median-dispersion/SBM-20-Geiger-Counter/Hardware/Geiger Tube Driver/PCB Back - Geiger Tube Driver.png

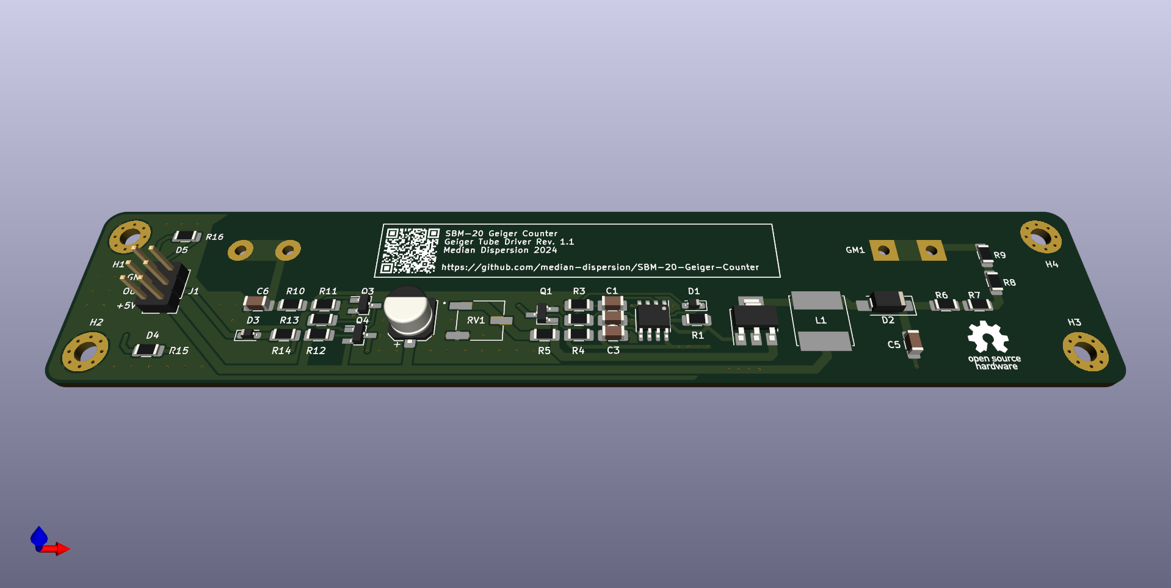
Hardware/Geiger Tube Driver/PCB Back - Geiger Tube Driver.png
