median-dispersion/SBM-20-Geiger-Counter/README.md

# SBM-20 Geiger Counter

### ⚠️  DISCLAIMER
This is a hobbyist project and should not be used to accurately determine radiation levels, especially not if those radiation levels are potentially dangerous and or lethal!
