median-dispersion/SBM-20-Geiger-Counter/Hardware/Geiger Counter Mainboard/Gerber/info.txt

--- Gerber Files ---
Date: 2024-01-08
KiCad: 7.0
PCB manufacturer: PCBWay (2-layer standard)
