median-dispersion/SBM-20-Geiger-Counter/Hardware/Geiger Tube Driver/Gerber/info.txt

--- Gerber Files ---
Date: 2024-01-07
KiCad: 7.0
PCB manufacturer: PCBWay (2-layer standard)
