median-dispersion/SBM-20-Geiger-Counter/Hardware/Geiger Counter Mainboard/PCB Back - Geiger Counter Mainboard.png

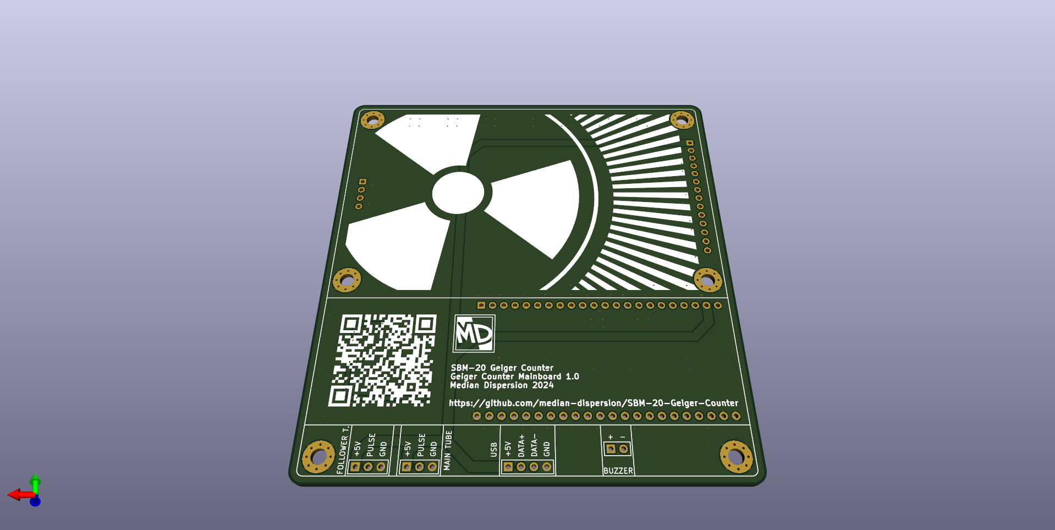
Hardware/Geiger Counter Mainboard/PCB Back - Geiger Counter Mainboard.png
