median-dispersion/SBM-20-Geiger-Counter/Hardware/Geiger Tube Driver/PCB Front - Geiger Tube Driver.png

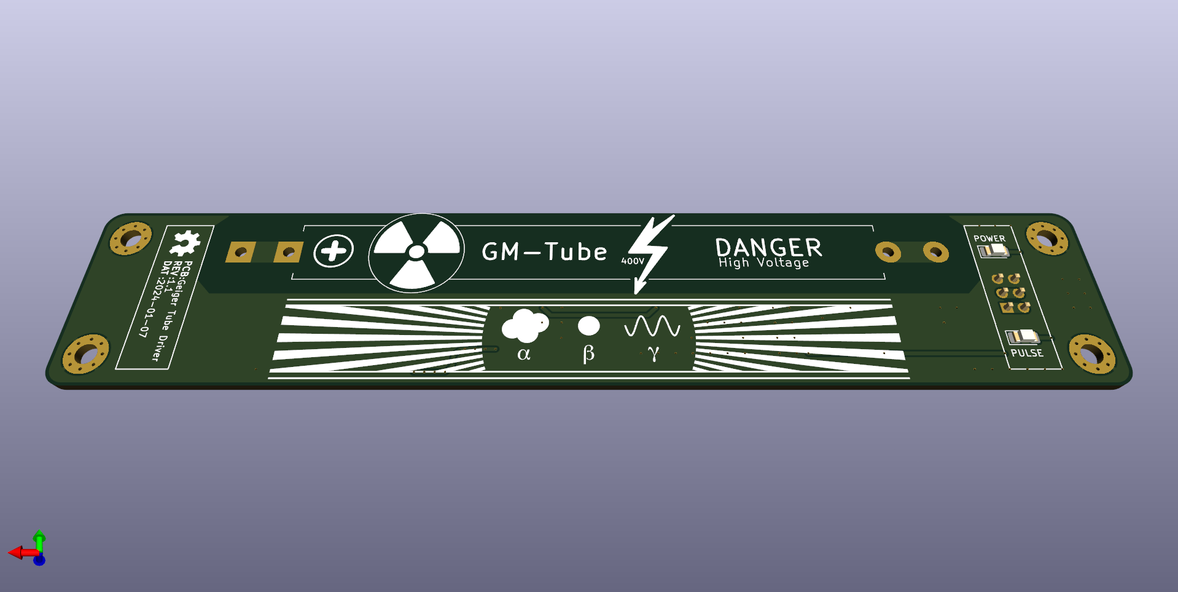
Hardware/Geiger Tube Driver/PCB Front - Geiger Tube Driver.png
