median-dispersion/SBM-20-Geiger-Counter/Hardware/Geiger Counter Mainboard/Schematic - Geiger Counter Mainboard.pdf

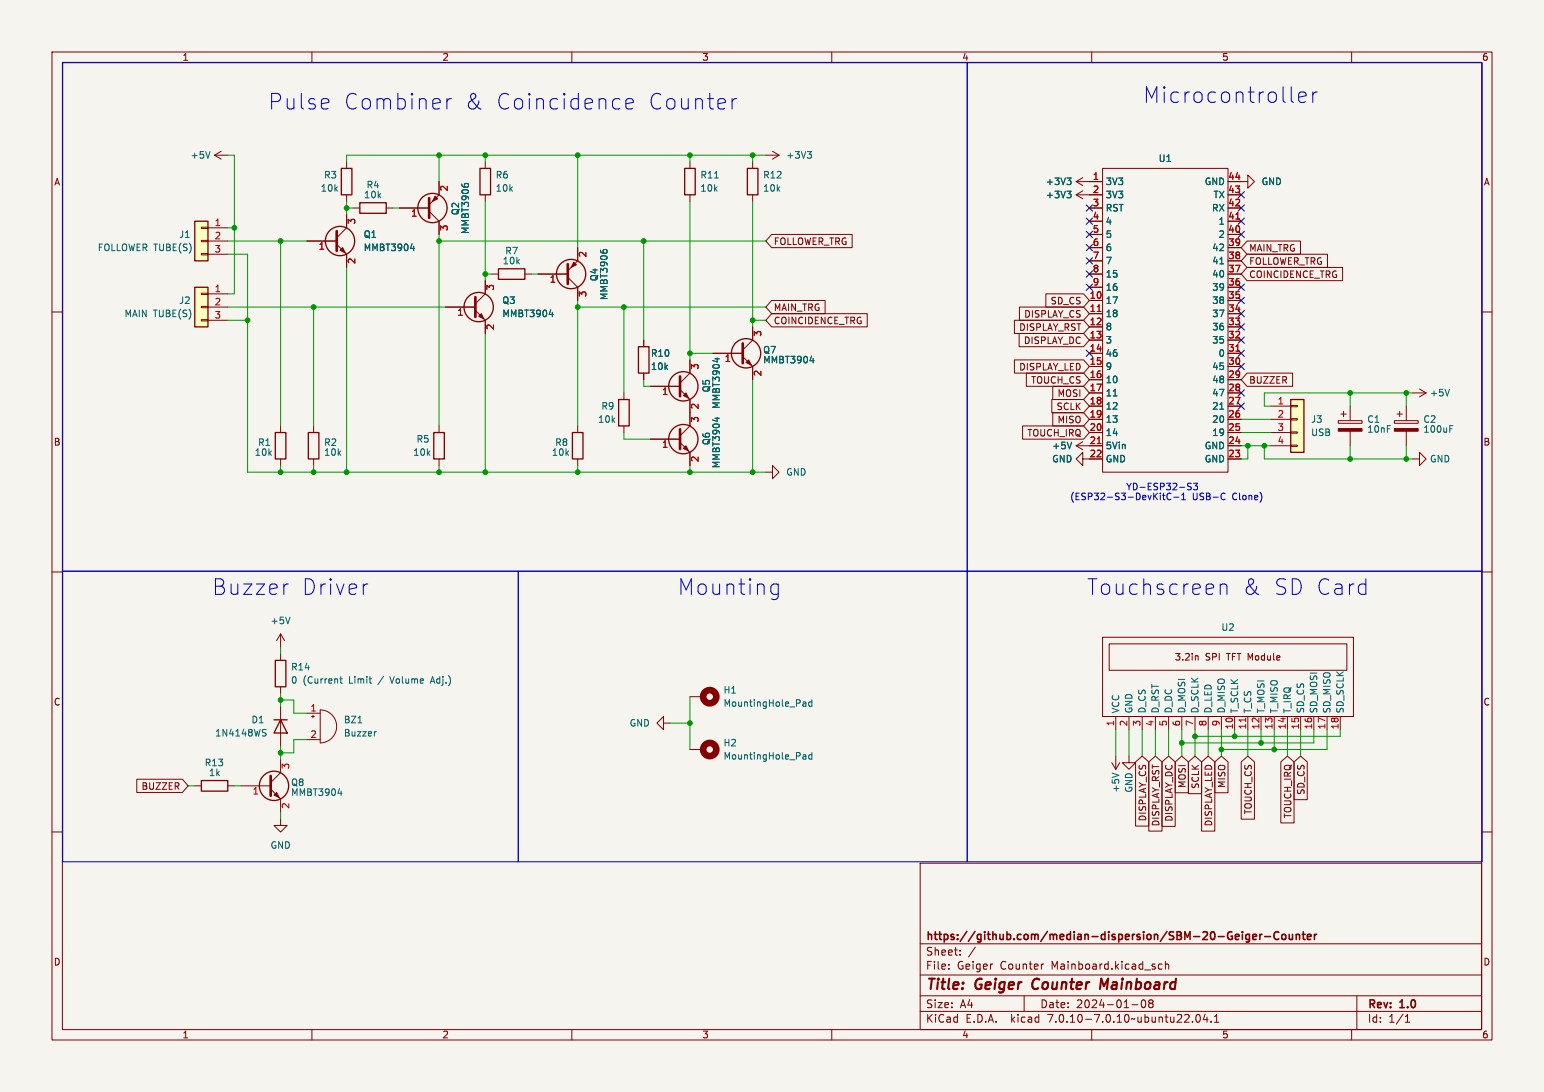
[picture p5: page 1]

Id: 1/1 Title: Geiger Counter Mainboard
