median-dispersion/SBM-20-Geiger-Counter/Hardware/Geiger Tube Driver/Schematic - Geiger Tube Driver.pdf

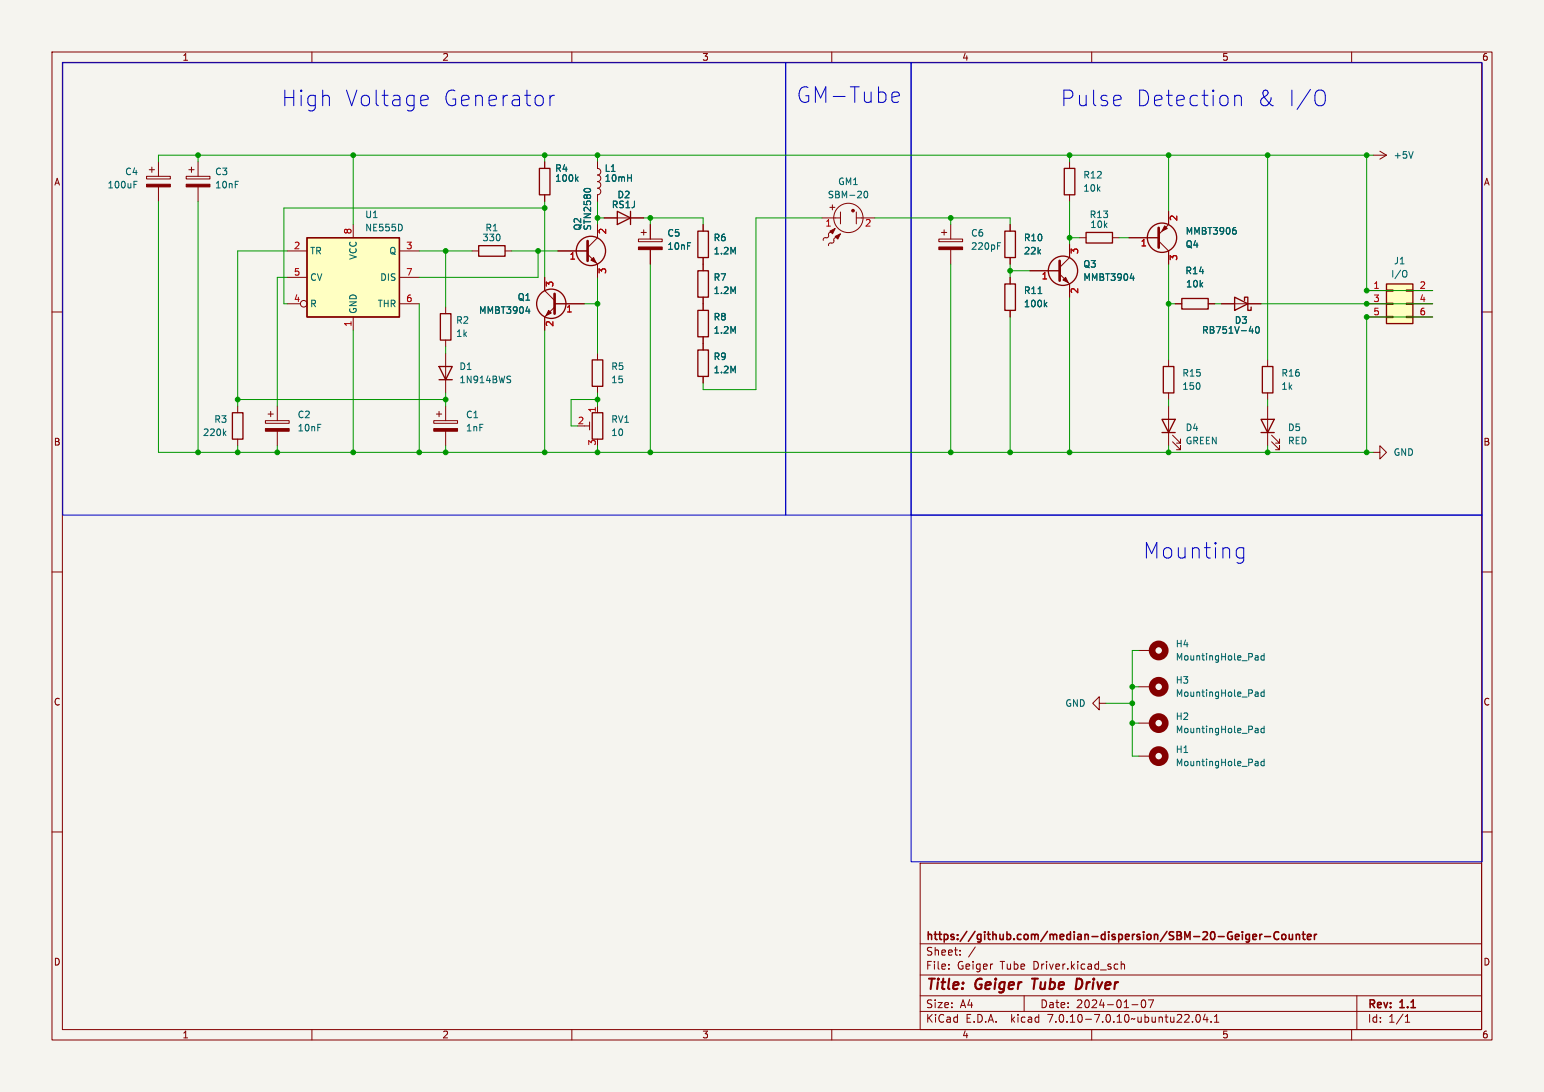
[picture p6: page 1]
