median-dispersion/SBM-20-Geiger-Counter/Hardware/Geiger Tube Driver/KiCad/Geiger Tube Driver.kicad_pcb

## KiCad design Hardware/Geiger Tube Driver/KiCad/Geiger Tube Driver.kicad_pcb (2024-01-09)

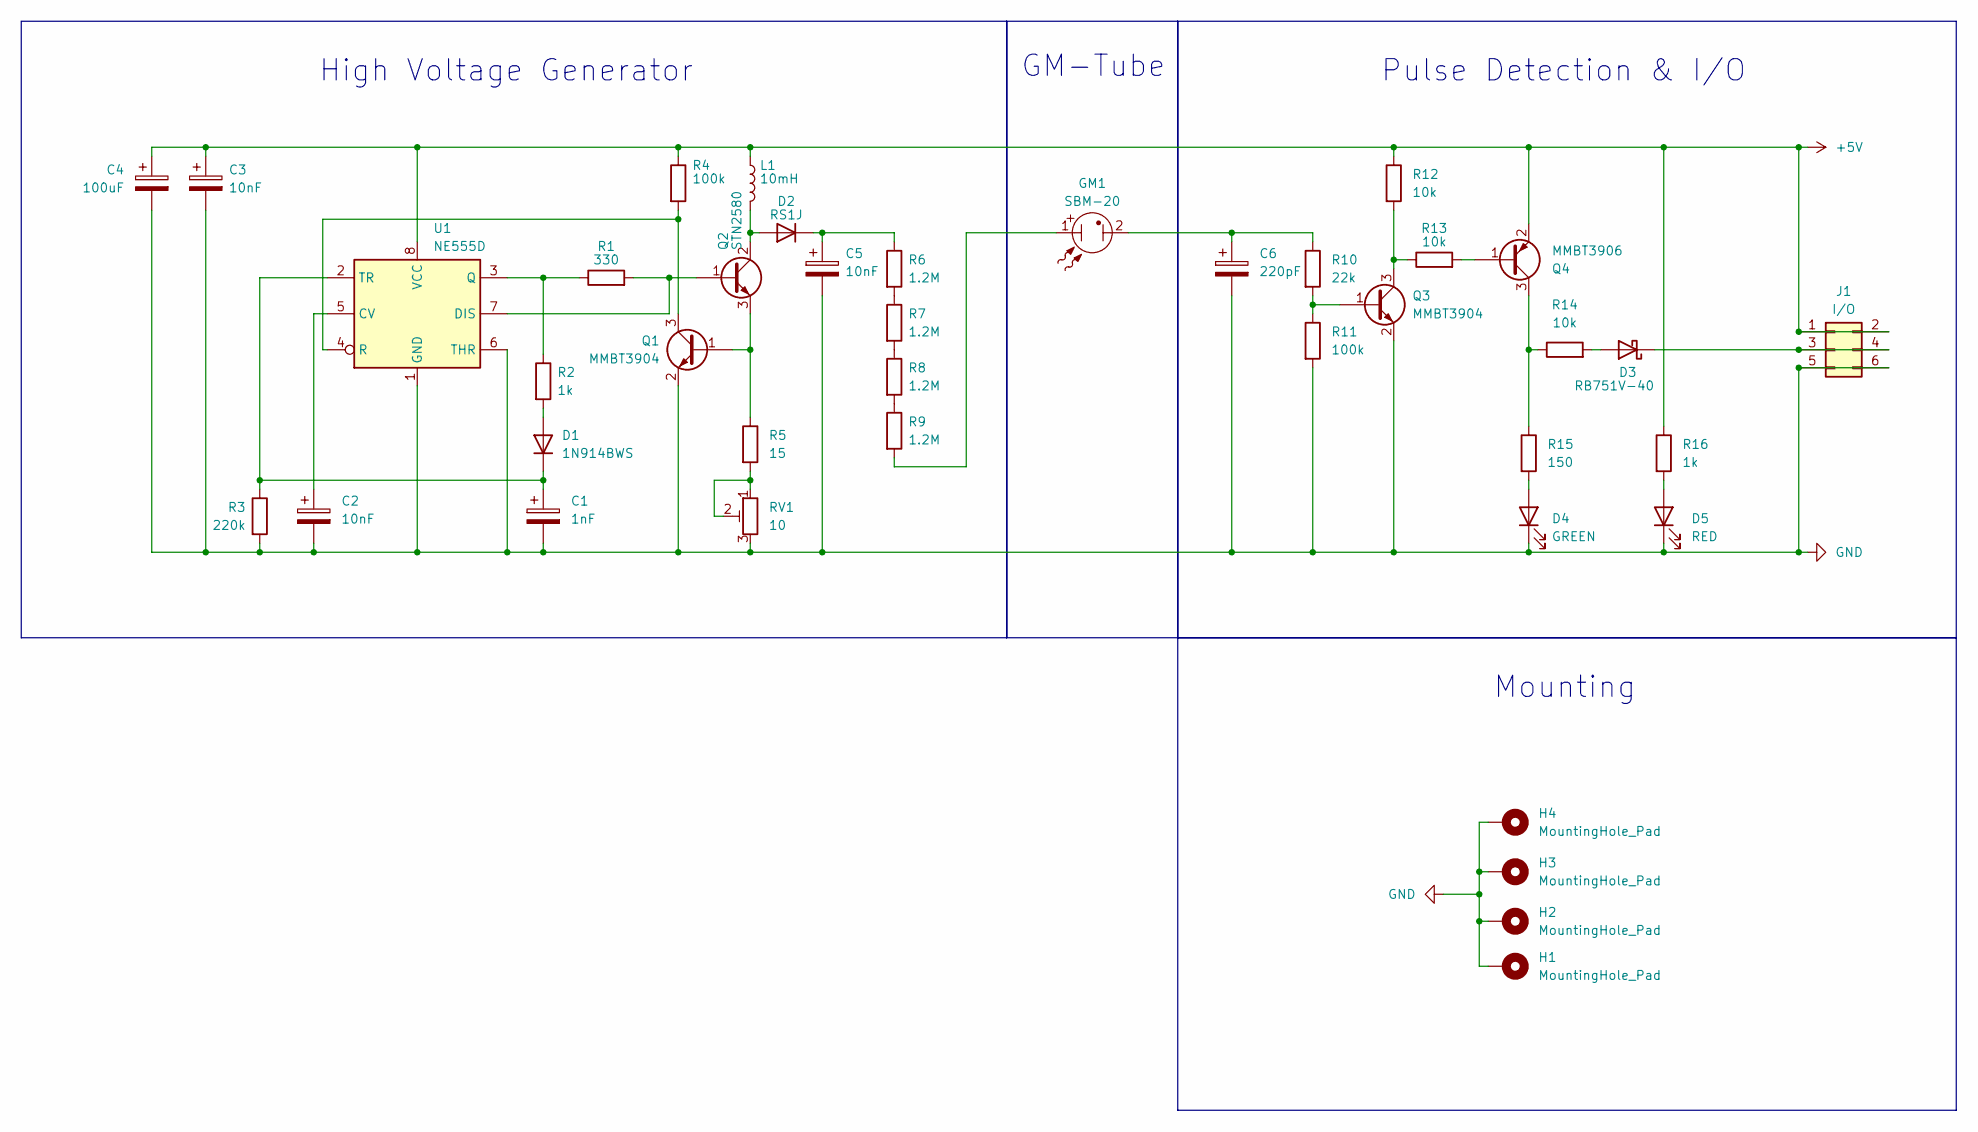
[picture p7: schematic Geiger Tube Driver.kicad_sch]

Parts:
C1: 1nF; C_1206_3216Metric_Pad1.33x1.80mm_HandSolder
C2, C3, C5: 10nF; C_1206_3216Metric_Pad1.33x1.80mm_HandSolder
C4: 100uF; CP_Elec_6.3x5.4
C6: 220pF; C_1206_3216Metric_Pad1.33x1.80mm_HandSolder
D1: 1N914BWS; D_SOD-323_HandSoldering
D2: RS1J; SMA_HV_Handsoldering
D3: RB751V-40; D_SOD-323_HandSoldering
D4: GREEN; LED_1206_3216Metric_Pad1.42x1.75mm_HandSolder
D5: RED; LED_1206_3216Metric_Pad1.42x1.75mm_HandSolder
GM1: SBM-20
H1, H2, H3, H4: MountingHole_Pad; MountingHole_3.2mm_M3_Pad_Via
J1: I/O; PinHeader_2x03_P2.54mm_Vertical
L1: 10mH; 8065_Handsoldering
Q1, Q3: MMBT3904; SOT-23_Handsoldering
Q2: STN2580; SOT-223-3_TabPin2
Q4: MMBT3906; SOT-23_Handsoldering
R1: 330; R_1206_3216Metric_Pad1.30x1.75mm_HandSolder
R2, R16: 1k; R_1206_3216Metric_Pad1.30x1.75mm_HandSolder
R3: 220k; R_1206_3216Metric_Pad1.30x1.75mm_HandSolder
R4, R11: 100k; R_1206_3216Metric_Pad1.30x1.75mm_HandSolder
R5: 15; R_1206_3216Metric_Pad1.30x1.75mm_HandSolder
R6, R7, R8, R9: 1.2M; R_1206_3216Metric_Pad1.30x1.75mm_HandSolder
R10: 22k; R_1206_3216Metric_Pad1.30x1.75mm_HandSolder
R12, R13, R14: 10k; R_1206_3216Metric_Pad1.30x1.75mm_HandSolder
R15: 150; R_1206_3216Metric_Pad1.30x1.75mm_HandSolder
RV1: 10; 3361P-1-100GLF
U1: NE555D; SOIC-8_3.9x4.9mm_P1.27mm

Connections:
+5V: C3.1, C4.1, J1.1, J1.2, L1.1, Q4.2 (E), R4.1, R12.1, R16.1, U1.8 (VCC)
GND: C1.2, C2.2, C3.2, C4.2, C5.2, C6.2, D4.1 (K), D5.1 (K), H1.1, H2.1, H3.1, H4.1, J1.5, J1.6, Q1.2 (E), Q3.2 (E), R3.2, R11.2, RV1.3, U1.1 (GND), U1.6 (THR)
unnamed: C6.1, GM1.2, R10.1
unnamed: D1.2 (A), R2.2
unnamed: C1.1, D1.1 (K), R3.1, U1.2 (TR)
unnamed: D2.2 (A), L1.2, Q2.2 (C), Q2.4 (C)
unnamed: C5.1, D2.1 (K), R6.1
unnamed: D3.2 (A), R14.2
unnamed: D3.1 (K), J1.3, J1.4
unnamed: D4.2 (A), R15.2
unnamed: D5.2 (A), R16.2
unnamed: GM1.1, R9.2
unnamed: Q1.1 (B), Q2.3 (E), R5.1
unnamed: Q1.3 (C), R4.2, U1.4 (R)
unnamed: Q2.1 (B), R1.2, U1.7 (DIS)
unnamed: Q3.1 (B), R10.2, R11.1
unnamed: Q3.3 (C), R12.2, R13.1
unnamed: Q4.1 (B), R13.2
unnamed: Q4.3 (C), R14.1, R15.1
unnamed: R5.2, RV1.1, RV1.2
unnamed: R6.2, R7.1
unnamed: R7.2, R8.1
unnamed: R8.2, R9.1
unnamed: C2.1, U1.5 (CV)
unnamed: R1.1, R2.1, U1.3 (Q)

Notes on the sheet:
Pulse Detection & I/O
High Voltage Generator
GM-Tube
Mounting

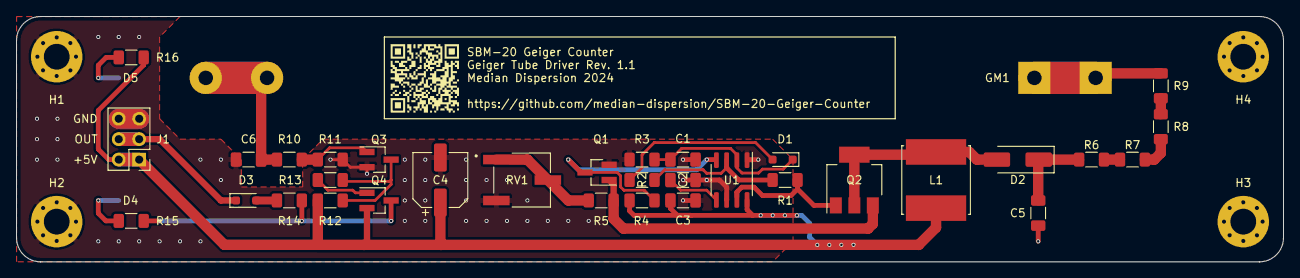
[picture p8: board Geiger Tube Driver.kicad_pcb from above]

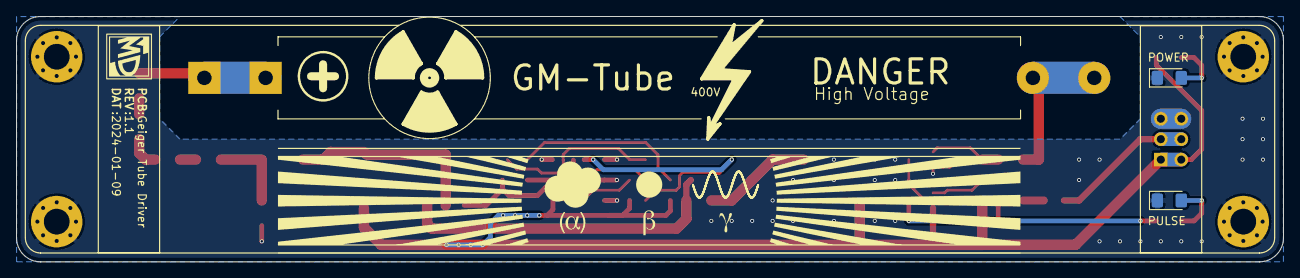
[picture p9: board Geiger Tube Driver.kicad_pcb from below]

Board: 2 copper layers, 157.5 x 30.5 mm, 40 parts (3 on the bottom side), 25 nets.
