median-dispersion/SBM-20-Geiger-Counter/Hardware/Geiger Counter Mainboard/KiCad/Geiger Counter Mainboard.kicad_pcb

## KiCad design Hardware/Geiger Counter Mainboard/KiCad/Geiger Counter Mainboard.kicad_pcb (2024-01-08)

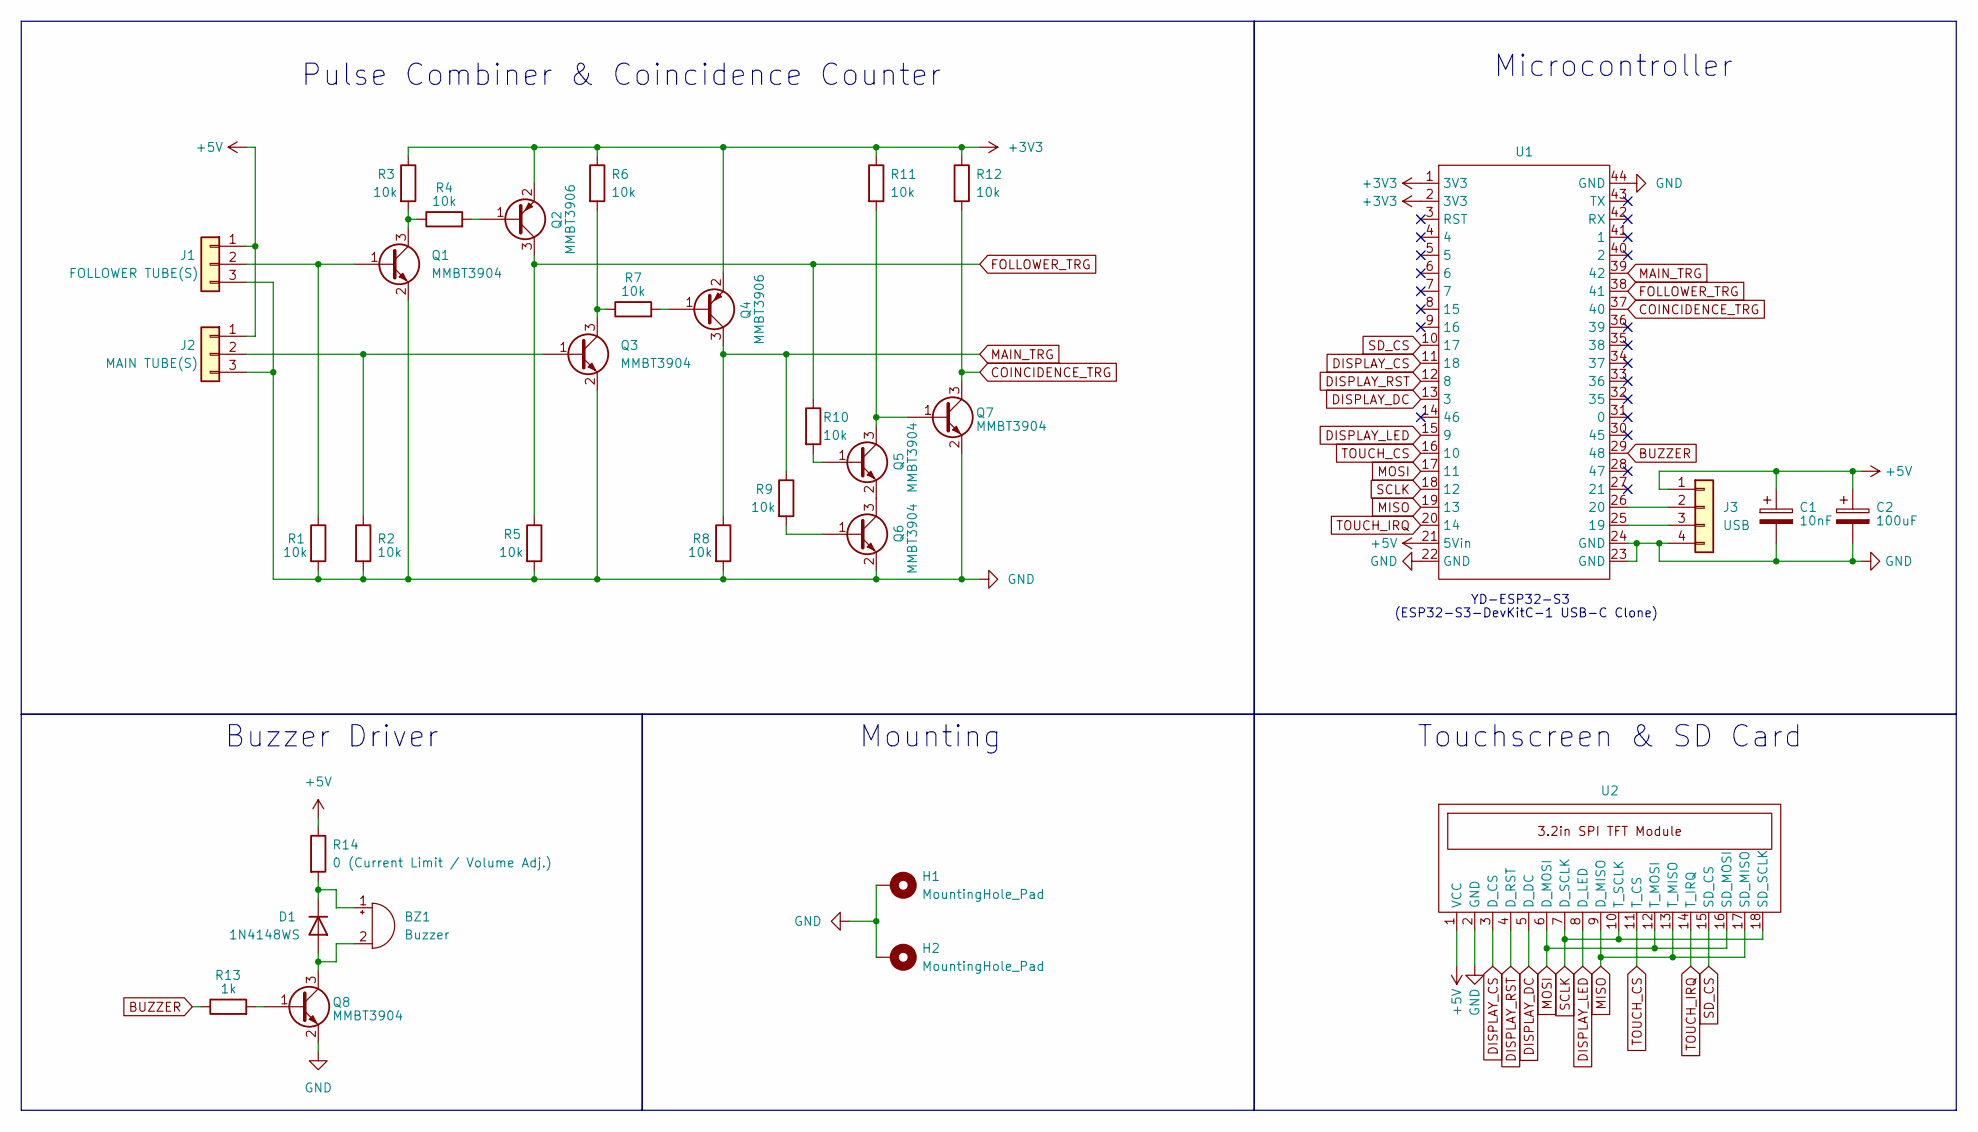
[picture p10: schematic Geiger Counter Mainboard.kicad_sch]

Parts:
BZ1: Buzzer; PinHeader_1x02_P2.54mm_Vertical
C1: 10nF; C_1206_3216Metric_Pad1.33x1.80mm_HandSolder
C2: 100uF; CP_Elec_6.3x5.4
D1: 1N4148WS; D_SOD-323_HandSoldering
H1, H2: MountingHole_Pad; MountingHole_3.2mm_M3_Pad_Via
J1: FOLLOWER TUBE(S); PinHeader_1x03_P2.54mm_Vertical
J2: MAIN TUBE(S); PinHeader_1x03_P2.54mm_Vertical
J3: USB; PinHeader_1x04_P2.54mm_Vertical
Q1, Q3, Q5, Q6, Q7, Q8: MMBT3904; SOT-23_Handsoldering
Q2, Q4: MMBT3906; SOT-23_Handsoldering
R1, R2, R3, R4, R5, R6, R7, R8, R9, R10, R11, R12: 10k; R_1206_3216Metric_Pad1.30x1.75mm_HandSolder
R13: 1k; R_1206_3216Metric_Pad1.30x1.75mm_HandSolder
R14: 0 (Current Limit / Volume Adj.); R_1206_3216Metric_Pad1.30x1.75mm_HandSolder
U1: YD-ESP32-S3 (ESP32-S3-DevKitC-1 USB-C Clone)
U2: 3.2in SPI TFT Touch Module

Connections:
+3V3: Q2.2 (E), Q4.2 (E), R3.1, R6.1, R11.1, R12.1, U1.1 (3V3), U1.2 (3V3)
+5V: C1.1, C2.1, J1.1, J2.1, J3.1, R14.1, U1.21 (5Vin), U2.1 (VCC)
BUZZER: R13.1, U1.29 (48)
COINCIDENCE_TRG: Q7.3 (C), R12.2, U1.37 (40)
DISPLAY_CS: U1.11 (18), U2.3 (D_CS)
DISPLAY_DC: U1.13 (3), U2.5 (D_DC)
DISPLAY_LED: U1.15 (9), U2.8 (D_LED)
DISPLAY_RST: U1.12 (8), U2.4 (D_RST)
FOLLOWER_TRG: Q2.3 (C), R5.1, R10.1, U1.38 (41)
GND: C1.2, C2.2, H1.1, H2.1, J1.3, J2.3, J3.4, Q1.2 (E), Q3.2 (E), Q6.2 (E), Q7.2 (E), Q8.2 (E), R1.2, R2.2, R5.2, R8.2, U1.22 (GND), U1.23 (GND), U1.24 (GND), U1.44 (GND), U2.2 (GND)
MAIN_TRG: Q4.3 (C), R8.1, R9.1, U1.39 (42)
MISO: U1.19 (13), U2.9 (D_MISO), U2.13 (T_MISO), U2.17 (SD_MISO)
MOSI: U1.17 (11), U2.6 (D_MOSI), U2.12 (T_MOSI), U2.16 (SD_MOSI)
unnamed: BZ1.2 (+), D1.2 (A), Q8.3 (C)
unnamed: BZ1.1 (-), D1.1 (K), R14.2
unnamed: J1.2, Q1.1 (B), R1.1
unnamed: J2.2, Q3.1 (B), R2.1
unnamed: J3.2, U1.26 (20)
unnamed: J3.3, U1.25 (19)
unnamed: Q1.3 (C), R3.2, R4.1
unnamed: Q2.1 (B), R4.2
unnamed: Q3.3 (C), R6.2, R7.1
unnamed: Q4.1 (B), R7.2
unnamed: Q5.1 (B), R10.2
unnamed: Q5.3 (C), Q7.1 (B), R11.2
unnamed: Q5.2 (E), Q6.3 (C)
unnamed: Q6.1 (B), R9.2
unnamed: Q8.1 (B), R13.2
SCLK: U1.18 (12), U2.7 (D_SCLK), U2.10 (T_SCLK), U2.18 (SD_SCLK)
SD_CS: U1.10 (17), U2.15 (SD_CS)
TOUCH_CS: U1.16 (10), U2.11 (T_CS)
TOUCH_IRQ: U1.20 (14), U2.14 (T_IRQ)

Notes on the sheet:
Pulse Combiner & Coincidence Counter
(ESP32-S3-DevKitC-1 USB-C Clone)
Buzzer Driver
Microcontroller
Mounting
Touchscreen & SD Card
YD-ESP32-S3

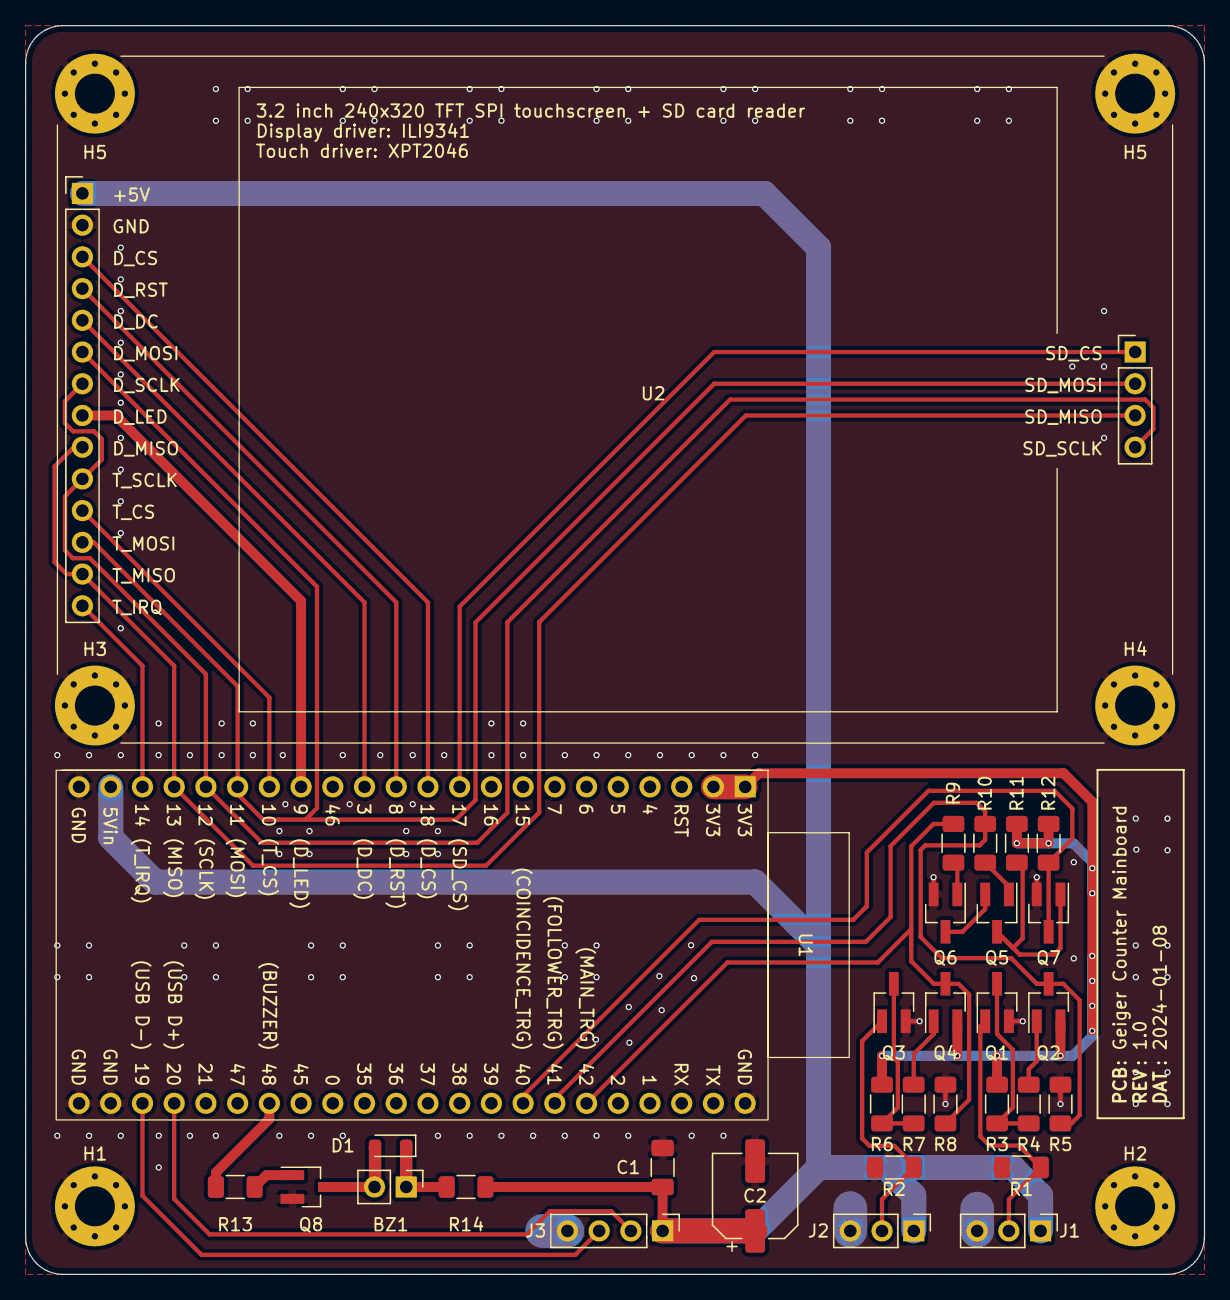
[picture p11: board Geiger Counter Mainboard.kicad_pcb from above]

Board: 2 copper layers, 94.4 x 100.0 mm, 33 parts (0 on the bottom side), 32 nets.
