median-dispersion/SBM-20-Geiger-Counter/(commit log)

2023-09-21 Added files for the Geiger tube driver board.
    [BoM - Geiger Tube Driver.csv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]
2023-12-29 Geiger Tube Driver Rev 1.1
    [BoM - Geiger Tube Driver.csv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]
2023-12-30 Adjusted mounting hole spacing
    [Geiger Tube Driver-B_Cu.gbr, Geiger Tube Driver-B_Mask.gbr, Geiger Tube Driver-B_Paste.gbr, Geiger Tube Driver-B_Silkscreen.gbr, Geiger Tube Driver-Edge_Cuts.gbr, Geiger Tube Driver-F_Cu.gbr, Geiger Tube Driver-F_Mask.gbr, Geiger Tube Driver-F_Paste.gbr]
2023-12-30 Added mainboard schematic
    [Geiger Counter Mainboard.kicad_pcb, Geiger Counter Mainboard.kicad_sch]
2023-12-31 Fixed BoM
    [BoM - Geiger Tube Driver.csv]
2024-01-02 Updated TFT module footprint
    [Geiger Counter Mainboard.kicad_sch]
2024-01-02 Updated TFT module footprint & schematic
    [Geiger Counter Mainboard.kicad_sch]
2024-01-07 Updated schematic & set PCB properties
    [Geiger Counter Mainboard.kicad_pcb, Geiger Counter Mainboard.kicad_sch]
2024-01-07 Added PCB for mainboard
    [Geiger Counter Mainboard.kicad_pcb, Geiger Counter Mainboard.kicad_sch]
2024-01-07 Organized schematics & rounded PCB corners
    [Geiger Tube Driver-B_Cu.gbr, Geiger Tube Driver-B_Mask.gbr, Geiger Tube Driver-B_Paste.gbr, Geiger Tube Driver-B_Silkscreen.gbr, Geiger Tube Driver-Edge_Cuts.gbr, Geiger Tube Driver-F_Cu.gbr, Geiger Tube Driver-F_Mask.gbr, Geiger Tube Driver-F_Paste.gbr]
2024-01-08 Finalizing Mainboard
    [Geiger Counter Mainboard-B_Cu.gbr, Geiger Counter Mainboard-B_Mask.gbr, Geiger Counter Mainboard-B_Paste.gbr, Geiger Counter Mainboard-B_Silkscreen.gbr, Geiger Counter Mainboard-Edge_Cuts.gbr, Geiger Counter Mainboard-F_Cu.gbr, Geiger Counter Mainboard-F_Mask.gbr, Geiger Counter Mainboard-F_Paste.gbr]
2024-01-09 Updated silkscreen
    [BoM - Geiger Tube Driver.csv, Geiger Tube Driver.kicad_pcb, Geiger Tube Driver.kicad_sch]
